danieldegrasse/FlexEval/BOM.xlsx

Sheet: Part Order
Required Qty | Ordered Quantity | Value | Device | Package | Parts | Digikey Part # | Stock (10/16/2022) | Cost Each | Total Cost | Description | A1_MIN | AVAILABILITY | A_MAX | A_MIN | A_NOM | B_MAX | B_MIN | B_NOM | COMMENT | CONFIGURATION_POLE-THROW | CONTACT_CURRENT_RATING | CPU | D1_MAX | D1_MIN | D1_NOM | D2_MAX | DESCRIPTION | DMAX | DMIN | DNOM | D_MAX | D_MIN | D_NOM | E1_MAX | E1_MIN | E1_NOM | E2_MAX | EMAX | EMIN | ENOM | EU_ROHS_COMPLIANCE | E_MAX | E_MIN | E_NOM | FLASHKB | L1_MAX | L1_MIN | L1_NOM | L_MAX | L_MIN | L_NOM | MANUFACTURER | MANUFACTURER_PART_NUMBER | MAXFREQUENCY | MF | MP | MPN | OC_FARNELL | OC_NEWARK
3 | 4 |  | 0603ESDA2-TR2 | 0603ESDA2-TR2 | TVS4, TVS5, TVS6 | 283-4156-1-ND | 95453 | $0.51 | $2.04 | TVS 0603ESDA2-TR2 ESD protection
5 | 5 | 1825910-7 | 1825910-7 | SW_1825910-7 | S1, S2, S3, S4, SW1 | 1825910-7 | 93559 | $0.13 | $0.65 | Switch Tactile OFF (ON) SPST Round Button PC Pins 0.05A 24VDC 100000Cycles 2.55N Thru-Hole Loose Check availability |  | In Stock |  |  |  |  |  |  | 1825910-7 | Single Pole - Single Throw | 50 mA |  |  |  |  |  | Switch Tactile OFF (ON) SPST Round Button PC Pins 0.05A 24VDC 100000Cycle 2.55N Thru-Hole Loose Piece |  |  |  |  |  |  |  |  |  |  |  |  |  | Compliant |  |  |  |  |  |  |  |  |  |  |  |  |  | TE Connectivity | 1825910-7
2 | 3 | 330 | 782853331SMD | 78285333 | L3, L4 | 732-782853331CT-ND | 3995 | $0.25 | $0.75 | 330mOhm Ferrite Bead
1 | 2 | ABM3B-8.000MHZ-B2-T | ABM3B-8.000MHZ-B2-T | OSC_ABM3B-8.000MHZ-B2-T | Y1 | 535-9720-1-ND | 458451 | $0.79 | $1.58 | 8MHz Â±20ppm Crystal 18pF 200 Ohms 4-SMD, No Lead Check availability Check availability Check availability |  | In Stock |  |  |  |  |  |  |  |  |  |  |  |  |  |  | 8 MHz Â±20ppm Crystal 18pF 200 Ohms 4-SMD, No Lead |  |  |  |  |  |  |  |  |  |  |  |  |  |  |  |  |  |  |  |  |  |  |  |  |  |  |  | Abracon | ABM3B-8.000MHZ-B2-T
1 | 2 | ABS07-32.768KHZ-T | ABS07-32.768KHZ-T | XTAL_ABS07-32.768KHZ-T | Y2 | 535-9542-1-ND | 1925810 | $0.73 | $1.46 | ABS07 Series 32.768 kHz Â±20 ppm 12.5 pF -40 to +85 Â°C SMT Low Profile Crystal Check availability |  | In Stock |  |  |  |  |  |  |  |  |  |  |  |  |  |  | 32.768 kHz Â±20ppm Crystal 12.5pF 70 kOhms 2-SMD, No Lead |  |  |  |  |  |  |  |  |  |  |  |  |  |  |  |  |  |  |  |  |  |  |  |  |  |  |  | Abracon | ABS07-32.768KHZ-T
1 | 1 | AP2115M-3.3TRG1 | AP2115M-3.3TRG1 | SOIC127P600X175-8N | U6 | AP2115M-3.3TRG1DICT-ND | 32319 | $0.40 | $0.40 | 3.3V LDO, 1A output max 6V (AP2115M-3.3TRG1)
4 | 6 | BAS16LT3G | BAS16LT3G | SOT95P240X111-3N | D1, D2, D3, D4 | BAS16LT3GOSCT-ND | 21195 | $0.11 | $0.66 | Diode Small Signal Switching 100V 0.2A Automotive 3-Pin SOT-23 T/R Check prices |  | In Stock |  |  |  |  |  |  |  |  |  |  |  |  |  |  | Diode Standard 100V 200mA (DC) Surface Mount SOT-23-3 (TO-236) |  |  |  |  |  |  |  |  |  |  |  |  |  |  |  |  |  |  |  |  |  |  |  |  |  |  |  | ON Semiconductor | BAS16LT3G
7 | 10 | 0.1uF | C-USC0805 | C0805 | C16, C18, C20, C24, C26, C28, C32 | 1276-1180-1-ND | 179561 | $0.10 | $1.00 | CAPACITOR, American symbol (35V rated min)
8 | 12 | 0.47uF | C-USC0805 | C0805 | C17, C19, C21, C22, C25, C27, C29, C30 | 1276-6482-1-ND | 498738 | $0.10 | $1.20 | CAPACITOR, American symbol (35V rated min)
2 | 3 | 12pF | C-USC0805 | C0805 | C33, C34 | 478-1305-1-ND | 57703 | $0.13 | $0.39 | CAPACITOR, American symbol (35V rated min)
1 | 2 | 2.2uF | C-USC0805 | C0805 | C12 | 1276-6702-1-ND | 80757 | $0.22 | $0.44 | CAPACITOR, American symbol (35V rated min)
2 | 3 | 4.7uF | C-USC0805 | C0805 | C13, C14 | 1276-1248-1-ND | 939972 | $0.23 | $0.69 | CAPACITOR, American symbol (35V rated min)
2 | 3 | 1000pF | C-USC1206 | C1206 | C1, C15 | 1276-1050-1-ND | 187675 | $0.11 | $0.33 | CAPACITOR, American symbol (35V rated min)
4 | 6 | 100nF | C-USC1206 | C1206 | C5, C6, C7, C9 | 1276-1017-1-ND | 1373363 | $0.11 | $0.66 | CAPACITOR, American symbol (35V rated min)
4 | 6 | 1uF | C-USC1206 | C1206 | C2, C3, C4, C8 | 1276-1068-1-ND | 910107 | $0.15 | $0.90 | CAPACITOR, American symbol (35V rated min)
2 | 3 | 22pF | C-USC1206 | C1206 | C10, C11 | 1276-1203-1-ND | 186092 | $0.14 | $0.42 | CAPACITOR, American symbol (35V rated min)
2 | 2 | 22uF | 860020672011 | 860020672011 | C23, C31 | 732-8857-1-ND | 23160 | $0.11 | $0.22 | 22uF 50V Electrolytic Capacitor Wurth 860020672011
1 | 2 | GRPB052VWQS-RC | GRPB052VWQS-RC | DEBUG | J2 | S9012E-05-ND | 113007 | $1.05 | $2.10 | CONN HEADER 0.050 | 10PS | DL | SMD | AU" |  | In Stock |  |  |  |  |  |  |  |  |  |  |  |  |  |  | Connector Header Surface Mount 10 position 0.050 (1.27mm) |  |  |  |  |  |  |  |  |  |  |  |  |  |  |  |  |  |  |  |  |  |  |  |  |  |  |  | Sullins Connector
2 | 6 | IS31FL3733B-TQLS4 | IS31FL3733B-TQLS4 | IS31FL3733B-TQLS4 | U3, U4 | 2521-IS31FL3733B-TQLS4-CT-ND | 2189 | $3.23 | $19.38 | IS31FL3733B
96 | 100 |  | LED3MM | LED3MM | LED1, LED2, LED3, LED4, LED5, LED6, LED7, LED8, LED9, LED10, LED11, LED12, LED13, LED14, LED15, LED16, LED17, LED18, LED19, LED20, LED21, LED22, LED23, LED24, LED25, LED26, LED27, LED28, LED29, LED30, LED31, LED32, LED33, LED34, LED35, LED36, LED37, LED38, LED39, LED40, LED41, LED42, LED43, LED44, LED45, LED46, LED47, LED48, LED49, LED50, LED51, LED52, LED53, LED54, LED55, LED56, LED57, LED58, LED59, LED60, LED61, LED62, LED63, LED64, LED65, LED66, LED67, LED68, LED69, LED70, LED71, LED72, LED73, LED74, LED75, LED76, LED77, LED78, LED79, LED80, LED81, LED82, LED83, LED84, LED85, LED86, LED87, LED88, LED89, LED90, LED91, LED92, LED93, LED94, LED95, LED96 | N/A-Order via Amazon (https://www.amazon.com/Transparent-Lighting-Electronics-Components-Emitting/dp/B01BTYHOMC) | ? | $0.07 | $7.00 | 3mm Flangeless LED
1 | 0 |  | MA04-1 | MA04-1 | SV1 | N/A- you have 2.54mm headers | ? | $0.00 | $0.00 | 4 pin 2.54mm pitch header (UART output) |  |  |  |  |  |  |  |  |  |  |  |  |  |  |  |  |  |  |  |  |  |  |  |  |  |  |  |  |  |  |  |  |  |  |  |  |  |  |  |  |  |  |  |  |  |  |  | unknown | unknown
1 | 0 | MK22FX512AVLQ12 | MK22FX512AVLQ12 | LQFP-144_20X20X1.6 | U1 | N/A-you have 5 on hand | 5 | $0.00 | $0.00 | Kinetis MK22FX512AVLQ12 MCU |  |  |  |  |  |  |  |  |  |  |  | ARM Cortex-M4 |  |  |  |  |  |  |  |  |  |  |  |  |  |  |  |  |  |  |  |  |  |  | 512 |  |  |  |  |  |  |  | MK22FX512AVLQ12 | 120
6 | 9 | 100K | R-US_R0805 | R0805 | R6, R7, R8, R14, R15, R16 | RMCF0805FT100KCT-ND | 5202790 | $0.10 | $0.90 | RESISTOR, American symbol
3 | 5 | 200 | R-US_R0805 | R0805 | R2, R3, R9 | RNCP0805FTD200RCT-ND | 147026 | $0.10 | $0.50 | RESISTOR, American symbol
2 | 4 | 33 | R-US_R0805 | R0805 | R10, R19 | A129731CT-ND | 39827 | $0.10 | $0.40 | RESISTOR, American symbol
2 | 4 | 4.7K | R-US_R0805 | R0805 | R4, R5 | 1292-WR08X4701FTLCT-ND | 71676 | $0.10 | $0.40 | RESISTOR, American symbol
2 | 4 | 420K | R-US_R0805 | R0805 | R17, R18 | 311-422KCRCT-ND | 164151 | $0.10 | $0.40 | RESISTOR, American symbol
2 | 4 | 5.1k | R-US_R0805 | R0805 | R20, R21 | A126379CT-ND | 31900 | $0.10 | $0.40 | RESISTOR, American symbol (CC resistors, must be 10% tolerance or better)
2 | 4 | 10k | R-US_R1206 | R1206 | R1, R11 | RNCP1206FTD10K0CT-ND | 270158 | $0.10 | $0.40 | RESISTOR, American symbol
1 | 1 | SOIC127P600X175-8N | TCN75AVOA713 | SOIC127P600X175-8N | U5 | TCN75AVOA713CT-ND | 16252 | $0.89 | $0.89 | TCN75A I2C temperature sensor (SOIC package) | 0.1 |  | 1.75 | 1.75 | 1.75 | 0.51 | 0.31 | 0.41 |  |  |  |  |  |  |  | 0 |  |  |  |  | 4.9 | 4.9 | 4.9 | 3.9 | 3.9 | 3.9 | 0 |  |  | 1.27 |  | 6 | 6 | 6 |  |  |  |  | 1.27 | 0.4 | 0.835 | hotchip
1 | 2 | UPS115UE3/TR7 | UPS115UE3/TR7 | UPS115UE3/TR7 | D5 | 150-UPS115UE3/TR7CT-ND | 1690 | $0.64 | $1.28 | Schottky diode (15V, 220mV@1A)
1 | 2 | USB4105-GF-A | USB4105-GF-A | GCT_USB4105-GF-A | J1 | 2073-USB4105-GF-ACT-ND | 75588 | $0.81 | $1.62 | USB-C (USB TYPE-C) USB 2.0 Receptacle Connector 24 (16+8 Dummy) Position Surface Mount, Right Angle; Through Hole Check availability |  | In Stock |  |  |  |  |  |  |  |  |  |  |  |  |  |  | USB-C (USB TYPE-C) USB 2.0 Receptacle Connector 24 (16+8 Dummy) Position Surface Mount, Right Angle | Through Hole |  |  |  |  |  |  |  |  |  |  |  |  |  |  |  |  |  |  |  |  |  |  |  |  |  |  |  | GCT | USB4105-GF-A
1 | 2 | RED | LEDSML1206 | SML1206 | LED98 | 160-1457-1-ND | 501653 | $0.31 | $0.62 | LED (Red, 1206 package)
1 | 2 | GREEN | LEDSML1206 | SML1206 | LED97 | 160-1456-1-ND | 286482 | $0.31 | $0.62 | LED (Green, 1206 package)
 |  |  |  |  |  |  |  |  | $49.46

Sheet: Parts List
Part | Value | Device | Package | Description | A1_MIN | AVAILABILITY | A_MAX | A_MIN | A_NOM | B_MAX | B_MIN | B_NOM | COMMENT | CONFIGURATION_POLE-THROW | CONTACT_CURRENT_RATING | CPU | D1_MAX | D1_MIN | D1_NOM | D2_MAX | DESCRIPTION | DMAX | DMIN | DNOM | D_MAX | D_MIN | D_NOM | E1_MAX | E1_MIN | E1_NOM | E2_MAX | EMAX | EMIN | ENOM | EU_ROHS_COMPLIANCE | E_MAX | E_MIN | E_NOM | FLASHKB | L1_MAX | L1_MIN | L1_NOM | L_MAX | L_MIN | L_NOM | MANUFACTURER | MANUFACTURER_PART_NUMBER | MAXFREQUENCY | MF | MP | MPN | OC_FARNELL | OC_NEWARK | PACKAGE | PACKAGE_TYPE | PINCOUNT | PINS | PIN_COUNT | POPULARITY
C1 | 1000pF | C-USC1206 | C1206 | CAPACITOR, American symbol
C10 | 22pF | C-USC1206 | C1206 | CAPACITOR, American symbol
C11 | 22pF | C-USC1206 | C1206 | CAPACITOR, American symbol
C12 | 2.2uF | C-USC0805 | C0805 | CAPACITOR, American symbol
C13 | 4.7uF | C-USC0805 | C0805 | CAPACITOR, American symbol
C14 | 4.7uF | C-USC0805 | C0805 | CAPACITOR, American symbol
C15 | 1000pF | C-USC1206 | C1206 | CAPACITOR, American symbol
C16 | 0.1uF | C-USC0805 | C0805 | CAPACITOR, American symbol
C17 | 0.47uF | C-USC0805 | C0805 | CAPACITOR, American symbol
C18 | 0.1uF | C-USC0805 | C0805 | CAPACITOR, American symbol
C19 | 0.47uF | C-USC0805 | C0805 | CAPACITOR, American symbol
C2 | 1uF | C-USC1206 | C1206 | CAPACITOR, American symbol
C20 | 0.1uF | C-USC0805 | C0805 | CAPACITOR, American symbol
C21 | 0.47uF | C-USC0805 | C0805 | CAPACITOR, American symbol
C22 | 0.47uF | C-USC0805 | C0805 | CAPACITOR, American symbol
C23 | 22uF | 860020672011 | 860020672011 | 22uF 50V Electrolytic Capacitor Wurth 860020672011
C24 | 0.1uF | C-USC0805 | C0805 | CAPACITOR, American symbol
C25 | 0.47uF | C-USC0805 | C0805 | CAPACITOR, American symbol
C26 | 0.1uF | C-USC0805 | C0805 | CAPACITOR, American symbol
C27 | 0.47uF | C-USC0805 | C0805 | CAPACITOR, American symbol
C28 | 0.1uF | C-USC0805 | C0805 | CAPACITOR, American symbol
C29 | 0.47uF | C-USC0805 | C0805 | CAPACITOR, American symbol
C3 | 1uF | C-USC1206 | C1206 | CAPACITOR, American symbol
C30 | 0.47uF | C-USC0805 | C0805 | CAPACITOR, American symbol
C31 | 22uF | 860020672011 | 860020672011 | 22uF 50V Electrolytic Capacitor Wurth 860020672011
C32 | 0.1uF | C-USC0805 | C0805 | CAPACITOR, American symbol
C33 | 12pF | C-USC0805 | C0805 | CAPACITOR, American symbol
C34 | 12pF | C-USC0805 | C0805 | CAPACITOR, American symbol
C4 | 1uF | C-USC1206 | C1206 | CAPACITOR, American symbol
C5 | 100nF | C-USC1206 | C1206 | CAPACITOR, American symbol
C6 | 100nF | C-USC1206 | C1206 | CAPACITOR, American symbol
C7 | 100nF | C-USC1206 | C1206 | CAPACITOR, American symbol
C8 | 1uF | C-USC1206 | C1206 | CAPACITOR, American symbol
C9 | 100nF | C-USC1206 | C1206 | CAPACITOR, American symbol
D1 | BAS16LT3G | BAS16LT3G | SOT95P240X111-3N | Diode Small Signal Switching 100V 0.2A Automotive 3-Pin SOT-23 T/R Check prices |  | In Stock |  |  |  |  |  |  |  |  |  |  |  |  |  |  | Diode Standard 100V 200mA (DC) Surface Mount SOT-23-3 (TO-236) |  |  |  |  |  |  |  |  |  |  |  |  |  |  |  |  |  |  |  |  |  |  |  |  |  |  |  | ON Semiconductor | BAS16LT3G |  |  |  | SOT-23-3 ON Semiconductor
D2 | BAS16LT3G | BAS16LT3G | SOT95P240X111-3N | Diode Small Signal Switching 100V 0.2A Automotive 3-Pin SOT-23 T/R Check prices |  | In Stock |  |  |  |  |  |  |  |  |  |  |  |  |  |  | Diode Standard 100V 200mA (DC) Surface Mount SOT-23-3 (TO-236) |  |  |  |  |  |  |  |  |  |  |  |  |  |  |  |  |  |  |  |  |  |  |  |  |  |  |  | ON Semiconductor | BAS16LT3G |  |  |  | SOT-23-3 ON Semiconductor
D3 | BAS16LT3G | BAS16LT3G | SOT95P240X111-3N | Diode Small Signal Switching 100V 0.2A Automotive 3-Pin SOT-23 T/R Check prices |  | In Stock |  |  |  |  |  |  |  |  |  |  |  |  |  |  | Diode Standard 100V 200mA (DC) Surface Mount SOT-23-3 (TO-236) |  |  |  |  |  |  |  |  |  |  |  |  |  |  |  |  |  |  |  |  |  |  |  |  |  |  |  | ON Semiconductor | BAS16LT3G |  |  |  | SOT-23-3 ON Semiconductor
D4 | BAS16LT3G | BAS16LT3G | SOT95P240X111-3N | Diode Small Signal Switching 100V 0.2A Automotive 3-Pin SOT-23 T/R Check prices |  | In Stock |  |  |  |  |  |  |  |  |  |  |  |  |  |  | Diode Standard 100V 200mA (DC) Surface Mount SOT-23-3 (TO-236) |  |  |  |  |  |  |  |  |  |  |  |  |  |  |  |  |  |  |  |  |  |  |  |  |  |  |  | ON Semiconductor | BAS16LT3G |  |  |  | SOT-23-3 ON Semiconductor
D5 | UPS115UE3/TR7 | UPS115UE3/TR7 | UPS115UE3/TR7 | Schottky diode (15V, 220mV@1A)
J1 | USB4105-GF-A | USB4105-GF-A | GCT_USB4105-GF-A | USB-C (USB TYPE-C) USB 2.0 Receptacle Connector 24 (16+8 Dummy) Position Surface Mount, Right Angle; Through Hole Check availability |  | In Stock |  |  |  |  |  |  |  |  |  |  |  |  |  |  | USB-C (USB TYPE-C) USB 2.0 Receptacle Connector 24 (16+8 Dummy) Position Surface Mount, Right Angle | Through Hole |  |  |  |  |  |  |  |  |  |  |  |  |  |  |  |  |  |  |  |  |  |  |  |  |  |  |  | GCT | USB4105-GF-A |  |  |  | None
J2 | GRPB052VWQS-RC | GRPB052VWQS-RC | DEBUG | CONN HEADER SMD 10POS 1.27MM (SWD debug header) | 10PS | DL | SMD | AU" |  | In Stock |  |  |  |  |  |  |  |  |  |  |  |  |  |  | Connector Header Surface Mount 10 position 0.050 (1.27mm) |  |  |  |  |  |  |  |  |  |  |  |  |  |  |  |  |  |  |  |  |  |  |  |  |  |  |  | Sullins Connector | GRPB052VWQS-RC |  |  |  | None
L3 | 330 | 782853331SMD | 78285333 | 330mOhm Ferrite Bead
L4 | 330 | 782853331SMD | 78285333 | 330mOhm Ferrite Bead
LED1 |  | LED3MM | LED3MM | 3mm Flangeless LED |  |  |  |  |  |  |  |  |  |  |  |  |  |  |  |  |  |  |  |  |  |  |  |  |  |  |  |  |  |  |  |  |  |  |  |  |  |  |  |  |  |  |  |  |  |  |  |  |  |  |  |  |  |  | 97
LED10 |  | LED3MM | LED3MM | 3mm Flangeless LED |  |  |  |  |  |  |  |  |  |  |  |  |  |  |  |  |  |  |  |  |  |  |  |  |  |  |  |  |  |  |  |  |  |  |  |  |  |  |  |  |  |  |  |  |  |  |  |  |  |  |  |  |  |  | 97
LED11 |  | LED3MM | LED3MM | 3mm Flangeless LED |  |  |  |  |  |  |  |  |  |  |  |  |  |  |  |  |  |  |  |  |  |  |  |  |  |  |  |  |  |  |  |  |  |  |  |  |  |  |  |  |  |  |  |  |  |  |  |  |  |  |  |  |  |  | 97
LED12 |  | LED3MM | LED3MM | 3mm Flangeless LED |  |  |  |  |  |  |  |  |  |  |  |  |  |  |  |  |  |  |  |  |  |  |  |  |  |  |  |  |  |  |  |  |  |  |  |  |  |  |  |  |  |  |  |  |  |  |  |  |  |  |  |  |  |  | 97
LED13 |  | LED3MM | LED3MM | 3mm Flangeless LED |  |  |  |  |  |  |  |  |  |  |  |  |  |  |  |  |  |  |  |  |  |  |  |  |  |  |  |  |  |  |  |  |  |  |  |  |  |  |  |  |  |  |  |  |  |  |  |  |  |  |  |  |  |  | 97
LED14 |  | LED3MM | LED3MM | 3mm Flangeless LED |  |  |  |  |  |  |  |  |  |  |  |  |  |  |  |  |  |  |  |  |  |  |  |  |  |  |  |  |  |  |  |  |  |  |  |  |  |  |  |  |  |  |  |  |  |  |  |  |  |  |  |  |  |  | 97
LED15 |  | LED3MM | LED3MM | 3mm Flangeless LED |  |  |  |  |  |  |  |  |  |  |  |  |  |  |  |  |  |  |  |  |  |  |  |  |  |  |  |  |  |  |  |  |  |  |  |  |  |  |  |  |  |  |  |  |  |  |  |  |  |  |  |  |  |  | 97
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
LED92 |  | LED3MM | LED3MM | 3mm Flangeless LED |  |  |  |  |  |  |  |  |  |  |  |  |  |  |  |  |  |  |  |  |  |  |  |  |  |  |  |  |  |  |  |  |  |  |  |  |  |  |  |  |  |  |  |  |  |  |  |  |  |  |  |  |  |  | 97
LED93 |  | LED3MM | LED3MM | 3mm Flangeless LED |  |  |  |  |  |  |  |  |  |  |  |  |  |  |  |  |  |  |  |  |  |  |  |  |  |  |  |  |  |  |  |  |  |  |  |  |  |  |  |  |  |  |  |  |  |  |  |  |  |  |  |  |  |  | 97
LED94 |  | LED3MM | LED3MM | 3mm Flangeless LED |  |  |  |  |  |  |  |  |  |  |  |  |  |  |  |  |  |  |  |  |  |  |  |  |  |  |  |  |  |  |  |  |  |  |  |  |  |  |  |  |  |  |  |  |  |  |  |  |  |  |  |  |  |  | 97
LED95 |  | LED3MM | LED3MM | 3mm Flangeless LED |  |  |  |  |  |  |  |  |  |  |  |  |  |  |  |  |  |  |  |  |  |  |  |  |  |  |  |  |  |  |  |  |  |  |  |  |  |  |  |  |  |  |  |  |  |  |  |  |  |  |  |  |  |  | 97
LED96 |  | LED3MM | LED3MM | 3mm Flangeless LED |  |  |  |  |  |  |  |  |  |  |  |  |  |  |  |  |  |  |  |  |  |  |  |  |  |  |  |  |  |  |  |  |  |  |  |  |  |  |  |  |  |  |  |  |  |  |  |  |  |  |  |  |  |  | 97
LED97 | GREEN | LEDSML1206 | SML1206 | LED |  |  |  |  |  |  |  |  |  |  |  |  |  |  |  |  |  |  |  |  |  |  |  |  |  |  |  |  |  |  |  |  |  |  |  |  |  |  |  |  |  |  |  |  |  |  |  |  |  |  |  |  |  |  | 6
LED98 | RED | LEDSML1206 | SML1206 | LED |  |  |  |  |  |  |  |  |  |  |  |  |  |  |  |  |  |  |  |  |  |  |  |  |  |  |  |  |  |  |  |  |  |  |  |  |  |  |  |  |  |  |  |  |  |  |  |  |  |  |  |  |  |  | 6
R1 | 10k | R-US_R1206 | R1206 | RESISTOR, American symbol
R10 | 33 | R-US_R0805 | R0805 | RESISTOR, American symbol
R11 | 10k | R-US_R1206 | R1206 | RESISTOR, American symbol
R14 | 100K | R-US_R0805 | R0805 | RESISTOR, American symbol
R15 | 100K | R-US_R0805 | R0805 | RESISTOR, American symbol
R16 | 100K | R-US_R0805 | R0805 | RESISTOR, American symbol
R17 | 420K | R-US_R0805 | R0805 | RESISTOR, American symbol
R18 | 420K | R-US_R0805 | R0805 | RESISTOR, American symbol
R19 | 33 | R-US_R0805 | R0805 | RESISTOR, American symbol
R2 | 200 | R-US_R0805 | R0805 | RESISTOR, American symbol
R20 | 5.1k | R-US_R0805 | R0805 | RESISTOR, American symbol
R21 | 5.1k | R-US_R0805 | R0805 | RESISTOR, American symbol
R3 | 200 | R-US_R0805 | R0805 | RESISTOR, American symbol
R4 | 4.7K | R-US_R0805 | R0805 | RESISTOR, American symbol
R5 | 4.7K | R-US_R0805 | R0805 | RESISTOR, American symbol
R6 | 100K | R-US_R0805 | R0805 | RESISTOR, American symbol
R7 | 100K | R-US_R0805 | R0805 | RESISTOR, American symbol
R8 | 100K | R-US_R0805 | R0805 | RESISTOR, American symbol
R9 | 200 | R-US_R0805 | R0805 | RESISTOR, American symbol
S1 | 1825910-7 | 1825910-7 | SW_1825910-7 | Switch Tactile OFF (ON) SPST Round Button PC Pins 0.05A 24VDC 100000Cycles 2.55N Thru-Hole Loose Check availability |  | In Stock |  |  |  |  |  |  | 1825910-7 | Single Pole - Single Throw | 50 mA |  |  |  |  |  | Switch Tactile OFF (ON) SPST Round Button PC Pins 0.05A 24VDC 100000Cycle 2.55N Thru-Hole Loose Piece |  |  |  |  |  |  |  |  |  |  |  |  |  | Compliant |  |  |  |  |  |  |  |  |  |  |  |  |  | TE Connectivity | 1825910-7 |  |  |  | None
S2 | 1825910-7 | 1825910-7 | SW_1825910-7 | Switch Tactile OFF (ON) SPST Round Button PC Pins 0.05A 24VDC 100000Cycles 2.55N Thru-Hole Loose Check availability |  | In Stock |  |  |  |  |  |  | 1825910-7 | Single Pole - Single Throw | 50 mA |  |  |  |  |  | Switch Tactile OFF (ON) SPST Round Button PC Pins 0.05A 24VDC 100000Cycle 2.55N Thru-Hole Loose Piece |  |  |  |  |  |  |  |  |  |  |  |  |  | Compliant |  |  |  |  |  |  |  |  |  |  |  |  |  | TE Connectivity | 1825910-7 |  |  |  | None
S3 | 1825910-7 | 1825910-7 | SW_1825910-7 | Switch Tactile OFF (ON) SPST Round Button PC Pins 0.05A 24VDC 100000Cycles 2.55N Thru-Hole Loose Check availability |  | In Stock |  |  |  |  |  |  | 1825910-7 | Single Pole - Single Throw | 50 mA |  |  |  |  |  | Switch Tactile OFF (ON) SPST Round Button PC Pins 0.05A 24VDC 100000Cycle 2.55N Thru-Hole Loose Piece |  |  |  |  |  |  |  |  |  |  |  |  |  | Compliant |  |  |  |  |  |  |  |  |  |  |  |  |  | TE Connectivity | 1825910-7 |  |  |  | None
S4 | 1825910-7 | 1825910-7 | SW_1825910-7 | Switch Tactile OFF (ON) SPST Round Button PC Pins 0.05A 24VDC 100000Cycles 2.55N Thru-Hole Loose Check availability |  | In Stock |  |  |  |  |  |  | 1825910-7 | Single Pole - Single Throw | 50 mA |  |  |  |  |  | Switch Tactile OFF (ON) SPST Round Button PC Pins 0.05A 24VDC 100000Cycle 2.55N Thru-Hole Loose Piece |  |  |  |  |  |  |  |  |  |  |  |  |  | Compliant |  |  |  |  |  |  |  |  |  |  |  |  |  | TE Connectivity | 1825910-7 |  |  |  | None
SJ1 |  | SJ2W | SJ_2 | SMD solder JUMPER |  |  |  |  |  |  |  |  |  |  |  |  |  |  |  |  |  |  |  |  |  |  |  |  |  |  |  |  |  |  |  |  |  |  |  |  |  |  |  |  |  |  |  |  |  |  |  |  |  |  |  |  |  |  | 7
SV1 |  | MA04-1 | MA04-1 | 4 pin 2.54mm pitch header (UART output) |  |  |  |  |  |  |  |  |  |  |  |  |  |  |  |  |  |  |  |  |  |  |  |  |  |  |  |  |  |  |  |  |  |  |  |  |  |  |  |  |  |  |  |  |  |  |  | unknown | unknown |  |  |  |  |  | 41
SW1 | 1825910-7 | 1825910-7 | SW_1825910-7 | Switch Tactile OFF (ON) SPST Round Button PC Pins 0.05A 24VDC 100000Cycles 2.55N Thru-Hole Loose Check availability |  | In Stock |  |  |  |  |  |  | 1825910-7 | Single Pole - Single Throw | 50 mA |  |  |  |  |  | Switch Tactile OFF (ON) SPST Round Button PC Pins 0.05A 24VDC 100000Cycle 2.55N Thru-Hole Loose Piece |  |  |  |  |  |  |  |  |  |  |  |  |  | Compliant |  |  |  |  |  |  |  |  |  |  |  |  |  | TE Connectivity | 1825910-7 |  |  |  | None
TP1 | TPSQTP20R | TPSQTP20R | TP20R | Test pad |  |  |  |  |  |  |  |  |  |  |  |  |  |  |  |  |  |  |  |  |  |  |  |  |  |  |  |  |  |  |  |  |  |  |  |  |  |  |  |  |  |  |  |  |  |  |  |  |  |  |  |  |  |  | 2
TP2 | TPSQTP20R | TPSQTP20R | TP20R | Test pad |  |  |  |  |  |  |  |  |  |  |  |  |  |  |  |  |  |  |  |  |  |  |  |  |  |  |  |  |  |  |  |  |  |  |  |  |  |  |  |  |  |  |  |  |  |  |  |  |  |  |  |  |  |  | 2
TP3 | TPSQTP20R | TPSQTP20R | TP20R | Test pad |  |  |  |  |  |  |  |  |  |  |  |  |  |  |  |  |  |  |  |  |  |  |  |  |  |  |  |  |  |  |  |  |  |  |  |  |  |  |  |  |  |  |  |  |  |  |  |  |  |  |  |  |  |  | 2
TP4 | TPSQTP20R | TPSQTP20R | TP20R | Test pad |  |  |  |  |  |  |  |  |  |  |  |  |  |  |  |  |  |  |  |  |  |  |  |  |  |  |  |  |  |  |  |  |  |  |  |  |  |  |  |  |  |  |  |  |  |  |  |  |  |  |  |  |  |  | 2
TP5 | TPSQTP20R | TPSQTP20R | TP20R | Test pad |  |  |  |  |  |  |  |  |  |  |  |  |  |  |  |  |  |  |  |  |  |  |  |  |  |  |  |  |  |  |  |  |  |  |  |  |  |  |  |  |  |  |  |  |  |  |  |  |  |  |  |  |  |  | 2
TVS4 |  | 0603ESDA2-TR2 | 0603ESDA2-TR2 | TVS 0603ESDA2-TR2 ESD protection
TVS5 |  | 0603ESDA2-TR2 | 0603ESDA2-TR2 | TVS 0603ESDA2-TR2 ESD protection
TVS6 |  | 0603ESDA2-TR2 | 0603ESDA2-TR2 | TVS 0603ESDA2-TR2 ESD protection
U1 | MK22FX512AVLQ12 | MK22FX512AVLQ12 | LQFP-144_20X20X1.6 | Kinetis MK22FX512AVLQ12 MCU |  |  |  |  |  |  |  |  |  |  |  | ARM Cortex-M4 |  |  |  |  |  |  |  |  |  |  |  |  |  |  |  |  |  |  |  |  |  |  | 512 |  |  |  |  |  |  |  | MK22FX512AVLQ12 | 120 |  |  |  |  |  |  |  | 144
U3 | IS31FL3733B-TQLS4 | IS31FL3733B-TQLS4 | IS31FL3733B-TQLS4 | IS31FL3733B LED Driver
U4 | IS31FL3733B-TQLS4 | IS31FL3733B-TQLS4 | IS31FL3733B-TQLS4 | IS31FL3733B LED Driver
U5 | SOIC127P600X175-8N | TCN75AVOA713 | SOIC127P600X175-8N | TCN75A I2C temperature sensor (SOIC package) | 0.1 |  | 1.75 | 1.75 | 1.75 | 0.51 | 0.31 | 0.41 |  |  |  |  |  |  |  | 0 |  |  |  |  | 4.9 | 4.9 | 4.9 | 3.9 | 3.9 | 3.9 | 0 |  |  | 1.27 |  | 6 | 6 | 6 |  |  |  |  | 1.27 | 0.4 | 0.835 | hotchip |  |  |  |  |  |  |  |  |  |  |  | 8
U6 | AP2115M-3.3TRG1 | AP2115M-3.3TRG1 | SOIC127P600X175-8N | 3.3V LDO, 1A output max 6V (AP2115M-3.3TRG1)
Y1 | ABM3B-8.000MHZ-B2-T | ABM3B-8.000MHZ-B2-T | OSC_ABM3B-8.000MHZ-B2-T | 8MHz Â±20ppm Crystal 18pF 200 Ohms 4-SMD, No Lead Check availability Check availability Check availability |  | In Stock |  |  |  |  |  |  |  |  |  |  |  |  |  |  | 8 MHz Â±20ppm Crystal 18pF 200 Ohms 4-SMD, No Lead |  |  |  |  |  |  |  |  |  |  |  |  |  |  |  |  |  |  |  |  |  |  |  |  |  |  |  | Abracon | ABM3B-8.000MHZ-B2-T |  |  |  | SMD-4 Abracon LLC
Y2 | ABS07-32.768KHZ-T | ABS07-32.768KHZ-T | XTAL_ABS07-32.768KHZ-T | ABS07 Series 32.768 kHz Â±20 ppm 12.5 pF -40 to +85 Â°C SMT Low Profile Crystal Check availability |  | In Stock |  |  |  |  |  |  |  |  |  |  |  |  |  |  | 32.768 kHz Â±20ppm Crystal 12.5pF 70 kOhms 2-SMD, No Lead |  |  |  |  |  |  |  |  |  |  |  |  |  |  |  |  |  |  |  |  |  |  |  |  |  |  |  | Abracon | ABS07-32.768KHZ-T |  |  |  | SMD-2 Abracon LLC
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
