danieldegrasse/FlexEval/SCHEMATIC.pdf

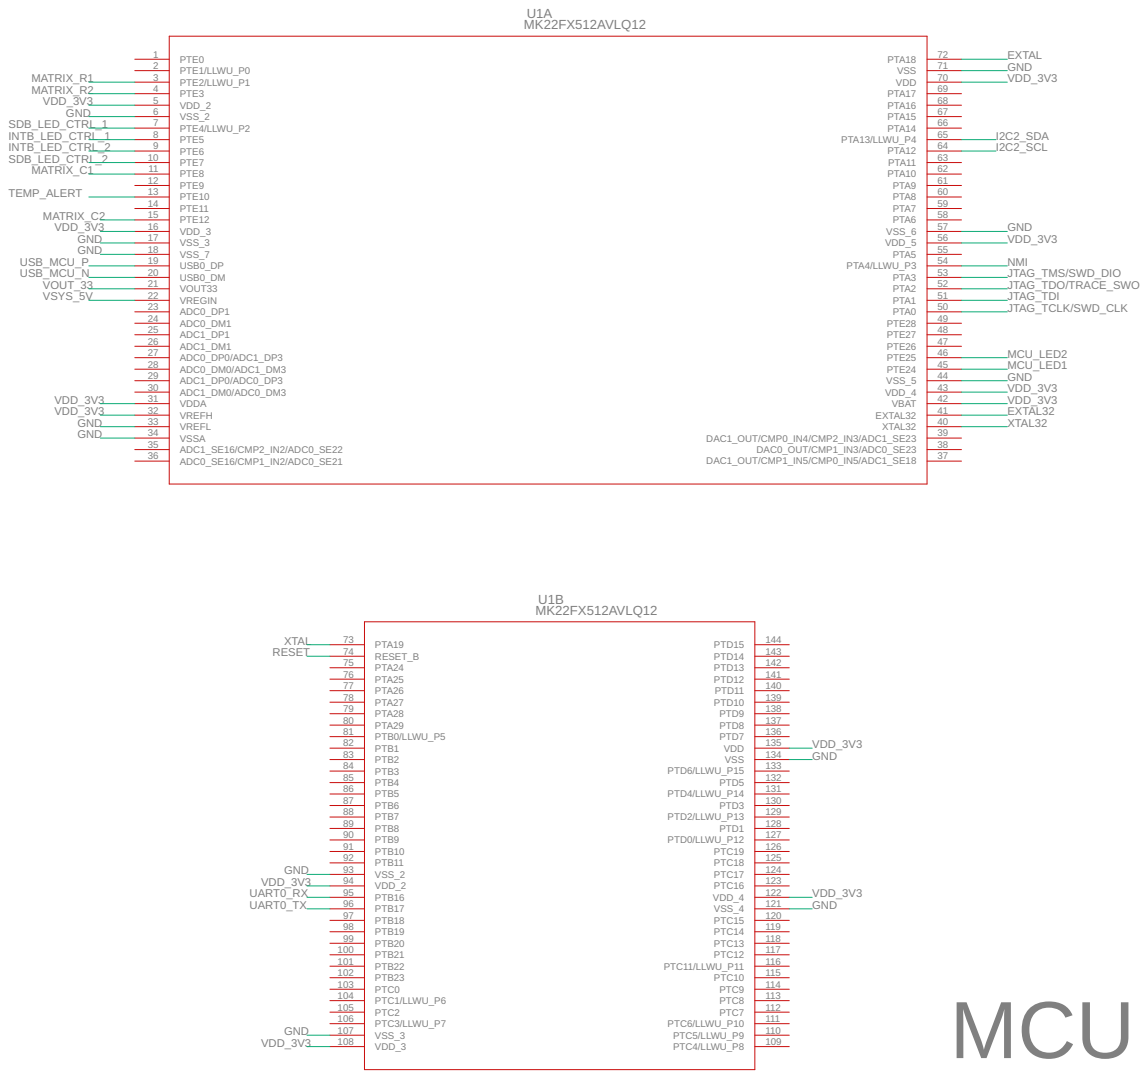
[picture p1: page 1]

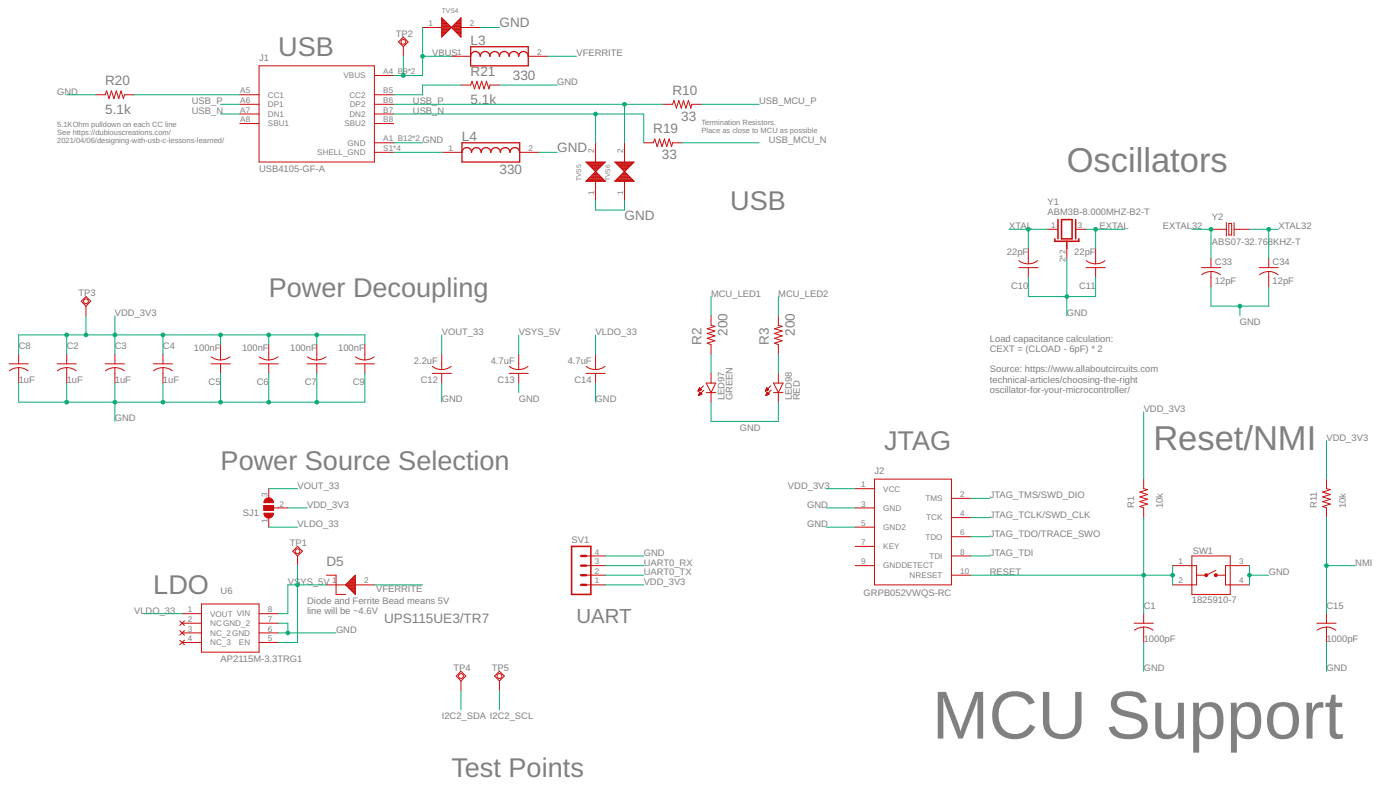
[picture p2: page 2]

Load capacitance calculation: CEXT = (CLOAD - 6pF) * 2 Source: https://www.allaboutcircuits.com

technical-articles/choosing-the-right oscillator-for-your-microcontroller/

VSYS_5V
Diode and Ferrite Bead means 5V
line will be ~4.6V
GND

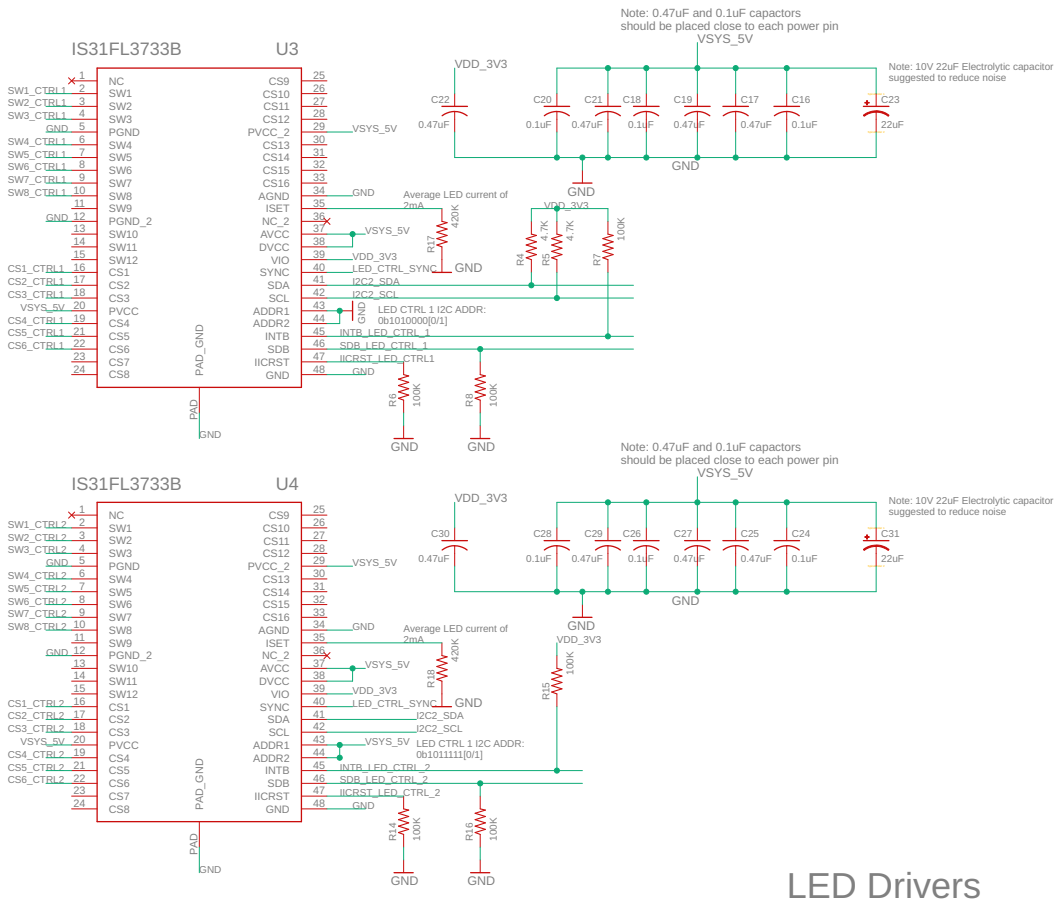
[picture p3: page 3]

Note: 0.47uF and 0.1uF capactors
should be placed close to each power pin

Note: 10V 22uF Electrolytic capacitor suggested to reduce noise

Average LED current of 2mA

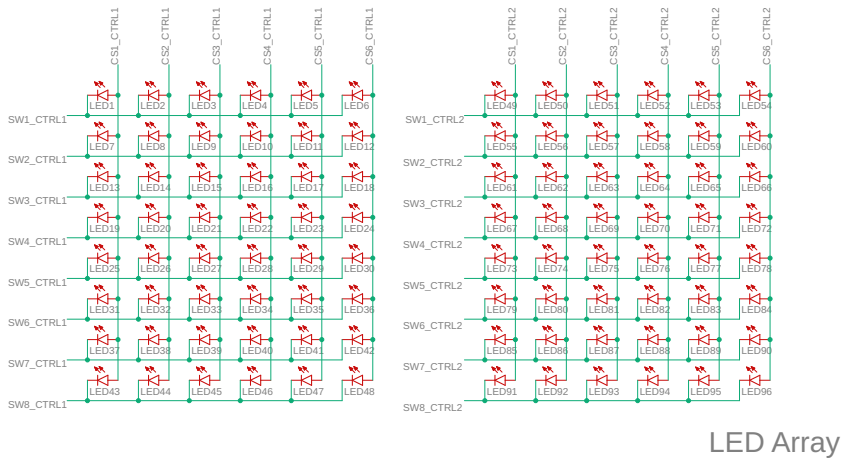
[picture p4: page 4]

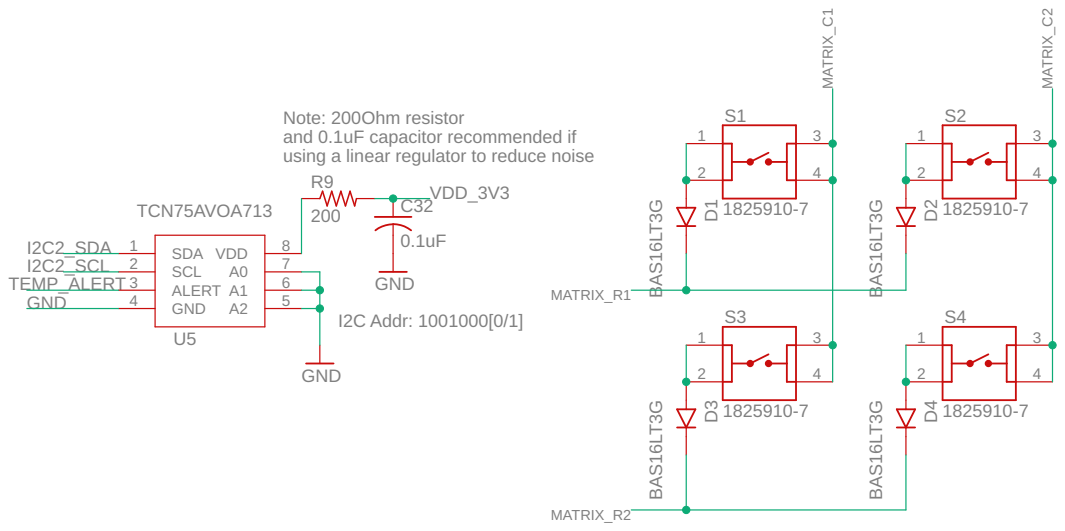
[picture p5: page 5]

Note: 200Ohm resistor and 0.1uF capacitor recommended if using a linear regulator to reduce noise TCN75AVOA713
