danieldegrasse/FlexEval/LAYOUT.pdf

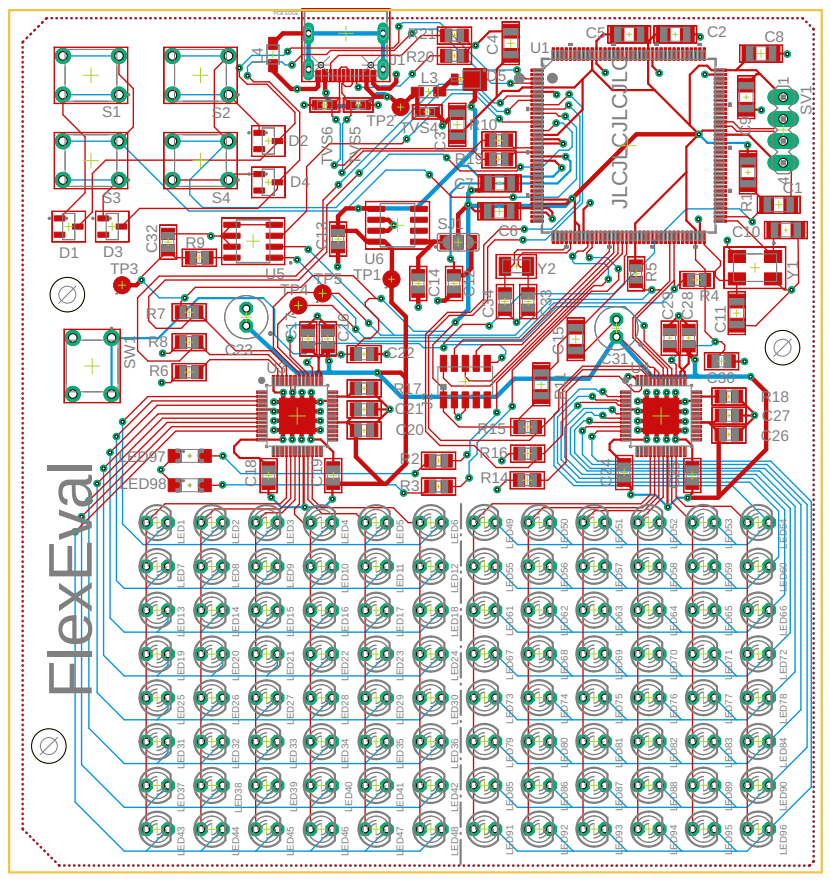
[picture p6: page 1]
