danieldegrasse/FlexEval/FlexEval.brd

## EAGLE design FlexEval.brd (2022-10-16)

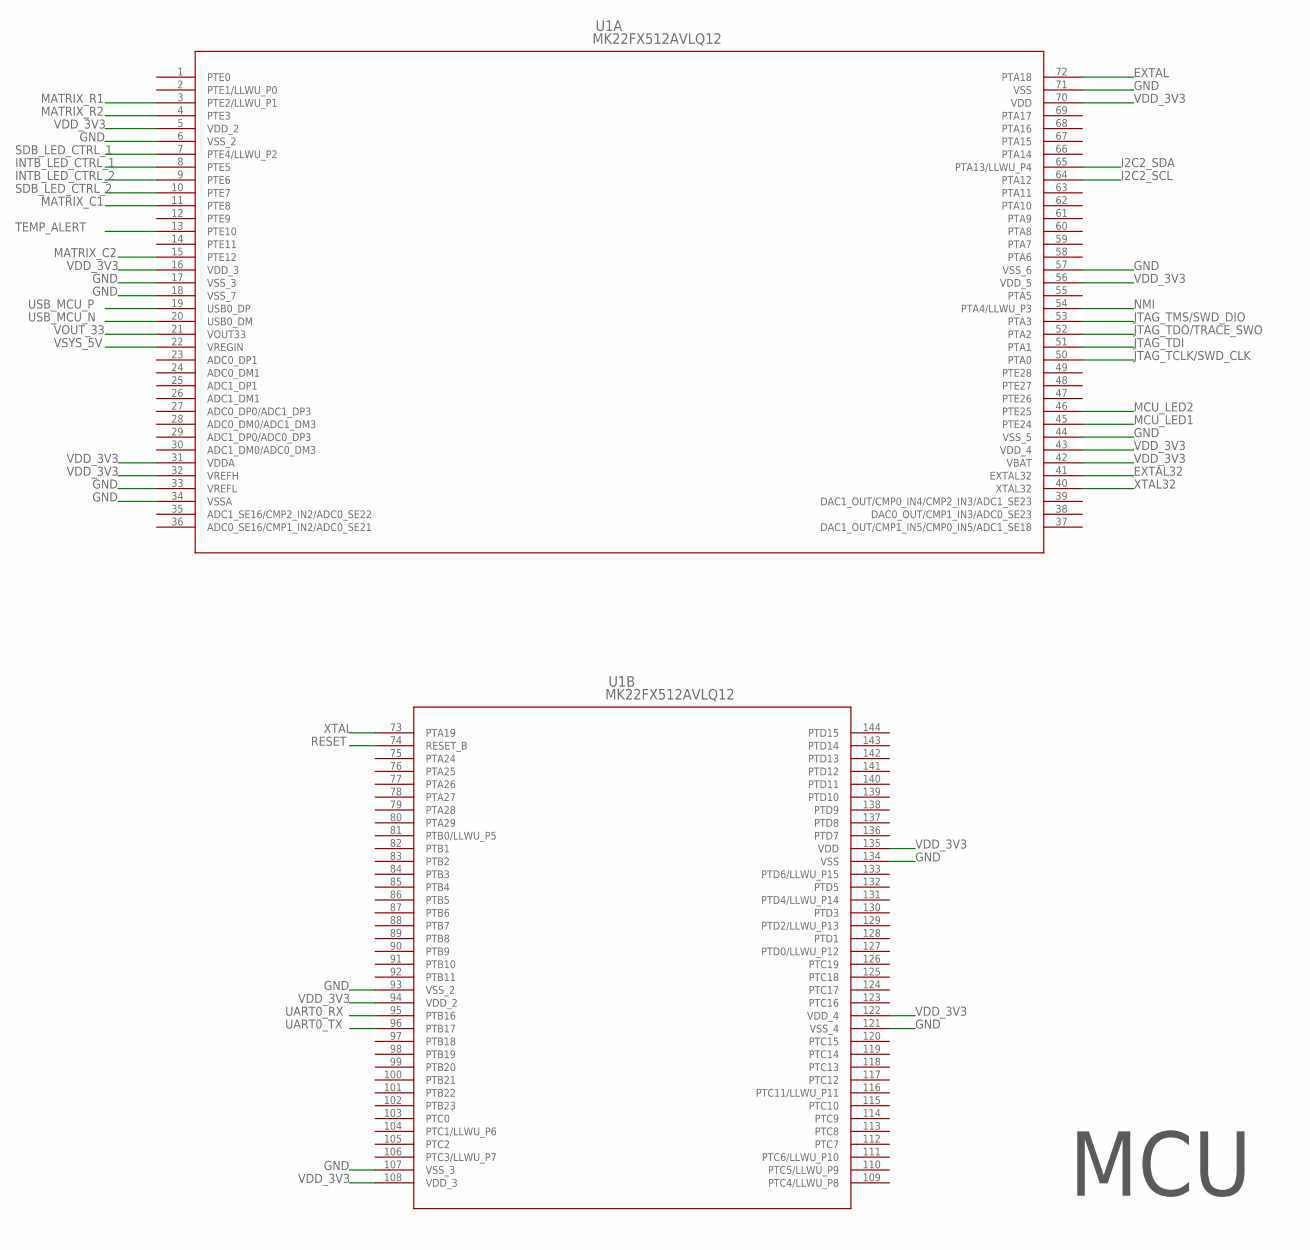
[picture p7: schematic FlexEval.sch, sheet 1]

Parts:
U1: MK22FX512AVLQ12; LQFP-144_20X20X1.6

Connections:
EXTAL: U1.72 (PTA18); also elsewhere on the board
EXTAL32: U1.41 (EXTAL32); also elsewhere on the board
GND: U1.6 (VSS_2), U1.17 (VSS_3), U1.18 (VSS_7), U1.33 (VREFL), U1.34 (VSSA), U1.44 (VSS_5), U1.57 (VSS_6), U1.71 (VSS), U1.93 (VSS_2), U1.107 (VSS_3), U1.121 (VSS_4), U1.134 (VSS); also elsewhere on the board
I2C2_SCL: U1.64 (PTA12); also elsewhere on the board
I2C2_SDA: U1.65 (PTA13/LLWU_P4); also elsewhere on the board
INTB_LED_CTRL_1: U1.8 (PTE5); also elsewhere on the board
INTB_LED_CTRL_2: U1.9 (PTE6); also elsewhere on the board
JTAG_TCLK/SWD_CLK: U1.50 (PTA0); also elsewhere on the board
JTAG_TDI: U1.51 (PTA1); also elsewhere on the board
JTAG_TDO/TRACE_SWO: U1.52 (PTA2); also elsewhere on the board
JTAG_TMS/SWD_DIO: U1.53 (PTA3); also elsewhere on the board
MATRIX_C1: U1.11 (PTE8); also elsewhere on the board
MATRIX_C2: U1.15 (PTE12); also elsewhere on the board
MATRIX_R1: U1.3 (PTE2/LLWU_P1); also elsewhere on the board
MATRIX_R2: U1.4 (PTE3); also elsewhere on the board
MCU_LED1: U1.45 (PTE24); also elsewhere on the board
MCU_LED2: U1.46 (PTE25); also elsewhere on the board
NMI: U1.54 (PTA4/LLWU_P3); also elsewhere on the board
RESET: U1.74 (RESET_B); also elsewhere on the board
SDB_LED_CTRL_1: U1.7 (PTE4/LLWU_P2); also elsewhere on the board
SDB_LED_CTRL_2: U1.10 (PTE7); also elsewhere on the board
TEMP_ALERT: U1.13 (PTE10); also elsewhere on the board
UART0_RX: U1.95 (PTB16); also elsewhere on the board
UART0_TX: U1.96 (PTB17); also elsewhere on the board
USB_MCU_N: U1.20 (USB0_DM); also elsewhere on the board
USB_MCU_P: U1.19 (USB0_DP); also elsewhere on the board
VDD_3V3: U1.5 (VDD_2), U1.16 (VDD_3), U1.31 (VDDA), U1.32 (VREFH), U1.42 (VBAT), U1.43 (VDD_4), U1.56 (VDD_5), U1.70 (VDD), U1.94 (VDD_2), U1.108 (VDD_3), U1.122 (VDD_4), U1.135 (VDD); also elsewhere on the board
VOUT_33: U1.21 (VOUT33); also elsewhere on the board
VSYS_5V: U1.22 (VREGIN); also elsewhere on the board
XTAL: U1.73 (PTA19); also elsewhere on the board
XTAL32: U1.40 (XTAL32); also elsewhere on the board

Notes on the sheet:
MCU

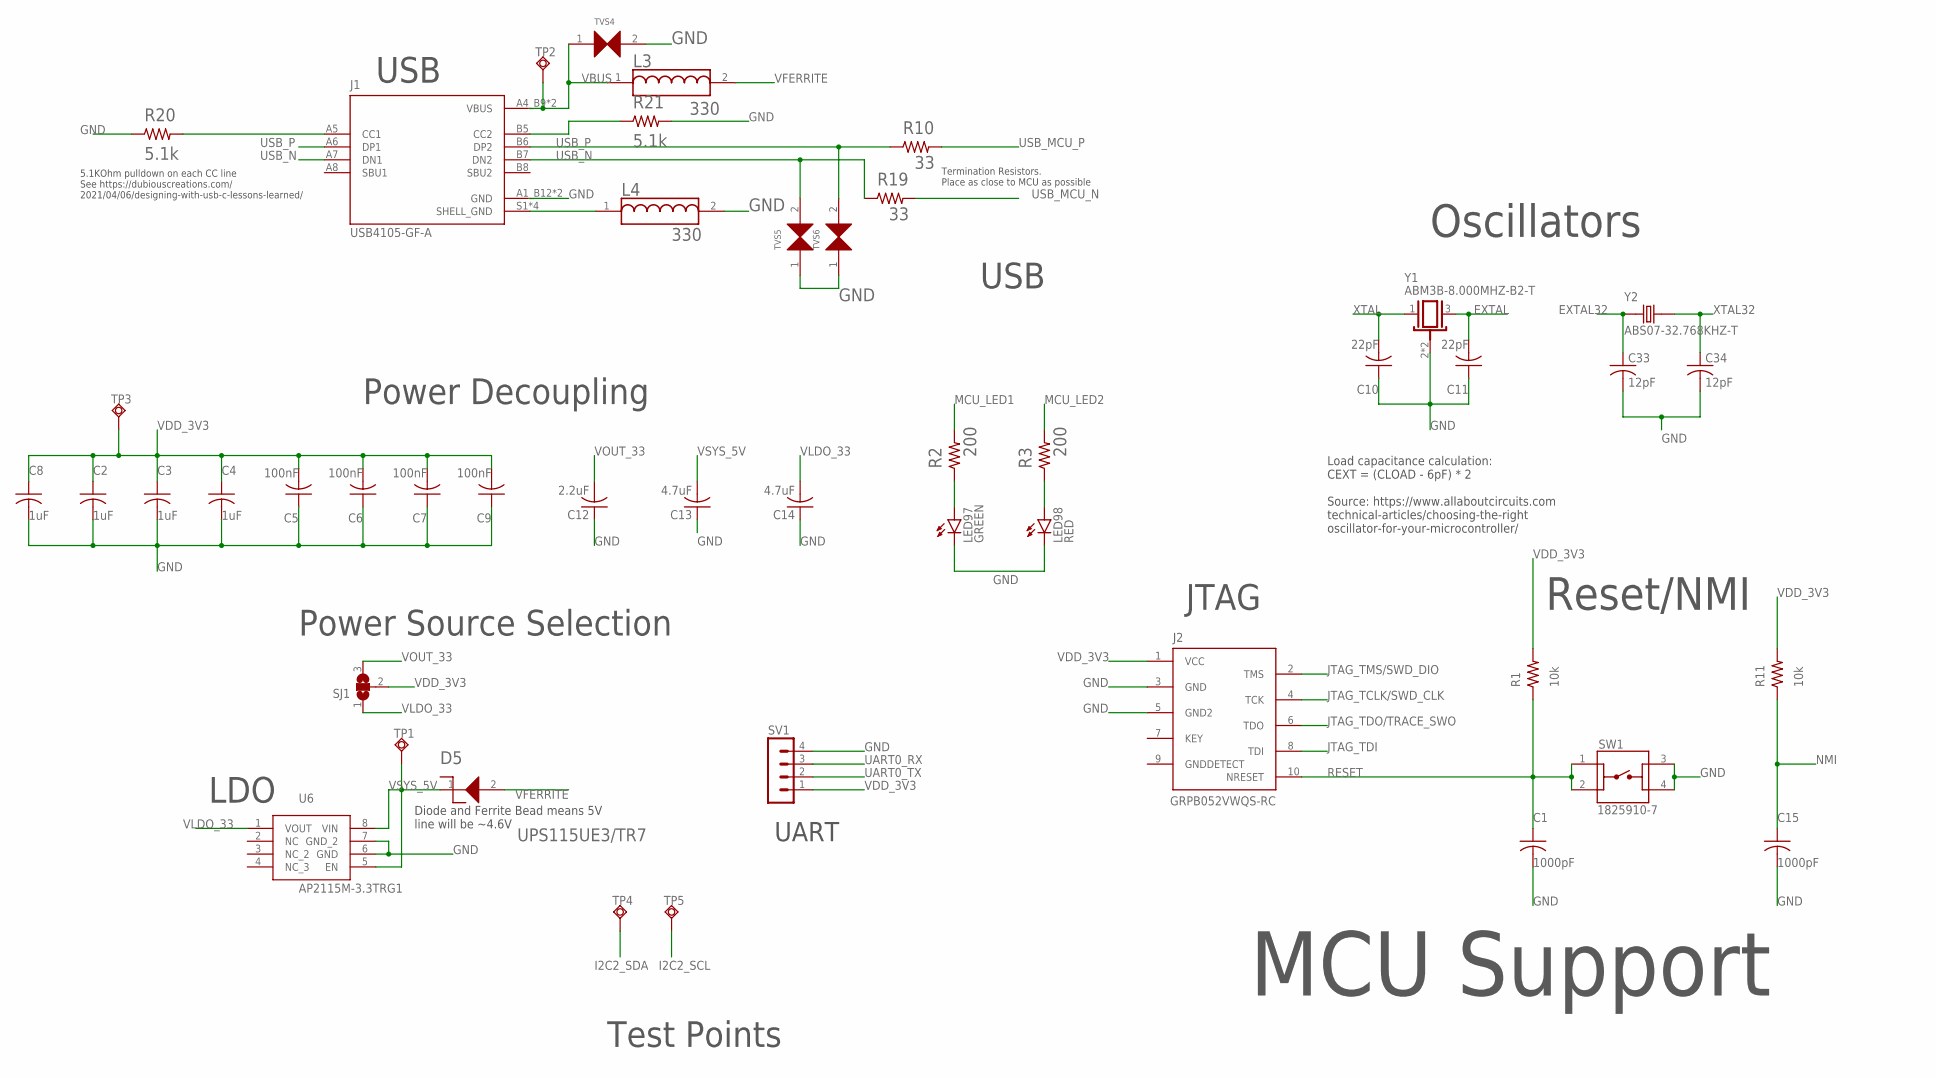
[picture p8: schematic FlexEval.sch, sheet 2]

Parts:
C1, C15: 1000pF; C1206
C2, C3, C4, C8: 1uF; C1206
C5, C6, C7, C9: 100nF; C1206
C10, C11: 22pF; C1206
C12: 2.2uF; C0805
C13, C14: 4.7uF; C0805
C33, C34: 12pF; C0805
D5: UPS115UE3/TR7
J1: USB4105-GF-A; GCT_USB4105-GF-A
J2: GRPB052VWQS-RC; DEBUG
L3, L4: 330; 78285333
LED97: GREEN; SML1206
LED98: RED; SML1206
R1, R11: 10k; R1206
R2, R3: 200; R0805
R10, R19: 33; R0805
R20, R21: 5.1k; R0805
SJ1: SJ2W; SJ_2
SV1: MA04-1
SW1: 1825910-7; SW_1825910-7
TP1, TP2, TP3, TP4, TP5: TPSQTP20R; TP20R
TVS4, TVS5, TVS6: 0603ESDA2-TR2
U6: AP2115M-3.3TRG1; SOIC127P600X175-8N
Y1: ABM3B-8.000MHZ-B2-T; OSC_ABM3B-8.000MHZ-B2-T
Y2: ABS07-32.768KHZ-T; XTAL_ABS07-32.768KHZ-T

Connections:
EXTAL: C11.2, Y1.3; also elsewhere on the board
EXTAL32: C33.1, Y2.1; also elsewhere on the board
GND: C1.2, C2.2, C3.2, C4.2, C5.1, C6.1, C7.1, C8.2, C9.1, C10.1, C11.1, C12.1, C13.1, C14.1, C15.2, C33.2, C34.2, J1.A1_B12 (GND), J1.B1_A12 (GND), J2.3 (GND), J2.5 (GND2), L4.2, LED97.C, LED98.C, R20.1, R21.2, SV1.4, SW1.3, SW1.4, TVS4.2, TVS5.1, TVS6.1, U6.6 (GND), U6.7 (GND_2), Y1.2 (GND), Y1.4 (GND); also elsewhere on the board
I2C2_SCL: TP5.TP; also elsewhere on the board
I2C2_SDA: TP4.TP; also elsewhere on the board
JTAG_TCLK/SWD_CLK: J2.4 (TCK); also elsewhere on the board
JTAG_TDI: J2.8 (TDI); also elsewhere on the board
JTAG_TDO/TRACE_SWO: J2.6 (TDO); also elsewhere on the board
JTAG_TMS/SWD_DIO: J2.2 (TMS); also elsewhere on the board
MCU_LED1: R2.2; also elsewhere on the board
MCU_LED2: R3.2; also elsewhere on the board
unnamed: LED97.A, R2.1
unnamed: LED98.A, R3.1
unnamed: J1.S1 (SHELL_GND), J1.S2 (SHELL_GND), J1.S3 (SHELL_GND), J1.S4 (SHELL_GND), L4.1
unnamed: J1.B5 (CC2), R21.1
unnamed: J1.A5 (CC1), R20.2
NMI: C15.1, R11.1; also elsewhere on the board
RESET: C1.1, J2.10 (NRESET), R1.1, SW1.1, SW1.2; also elsewhere on the board
UART0_RX: SV1.3; also elsewhere on the board
UART0_TX: SV1.2; also elsewhere on the board
USB_MCU_N: R19.2; also elsewhere on the board
USB_MCU_P: R10.2; also elsewhere on the board
USB_N: J1.A7 (DN1), J1.B7 (DN2), R19.1, TVS5.2
USB_P: J1.A6 (DP1), J1.B6 (DP2), R10.1, TVS6.2
VBUS: J1.A4_B9 (VBUS), J1.B4_A9 (VBUS), L3.1, TP2.TP, TVS4.1
VDD_3V3: C2.1, C3.1, C4.1, C5.2, C6.2, C7.2, C8.1, C9.2, J2.1 (VCC), R1.2, R11.2, SJ1.2, SV1.1, TP3.TP; also elsewhere on the board
VFERRITE: D5.2, L3.2
VLDO_33: C14.2, SJ1.1, U6.1 (VOUT)
VOUT_33: C12.2, SJ1.3; also elsewhere on the board
VSYS_5V: C13.2, D5.1, TP1.TP, U6.5 (EN), U6.8 (VIN); also elsewhere on the board
XTAL: C10.2, Y1.1; also elsewhere on the board
XTAL32: C34.1, Y2.2; also elsewhere on the board

Notes on the sheet:
USB
JTAG
UART
Power Source Selection
Power Decoupling
LDO
Reset/NMI
Oscillators
MCU Support
Diode and Ferrite Bead means 5V line will be ~4.6V
Load capacitance calculation: CEXT = (CLOAD - 6pF) * 2 Source: https://www.allaboutcircuits.com technical-articles/choosing-the-right oscillator-for-your-microcontroller/
5.1KOhm pulldown on each CC line See https://dubiouscreations.com/ 2021/04/06/designing-with-usb-c-lessons-learned/
Termination Resistors. Place as close to MCU as possible
Test Points

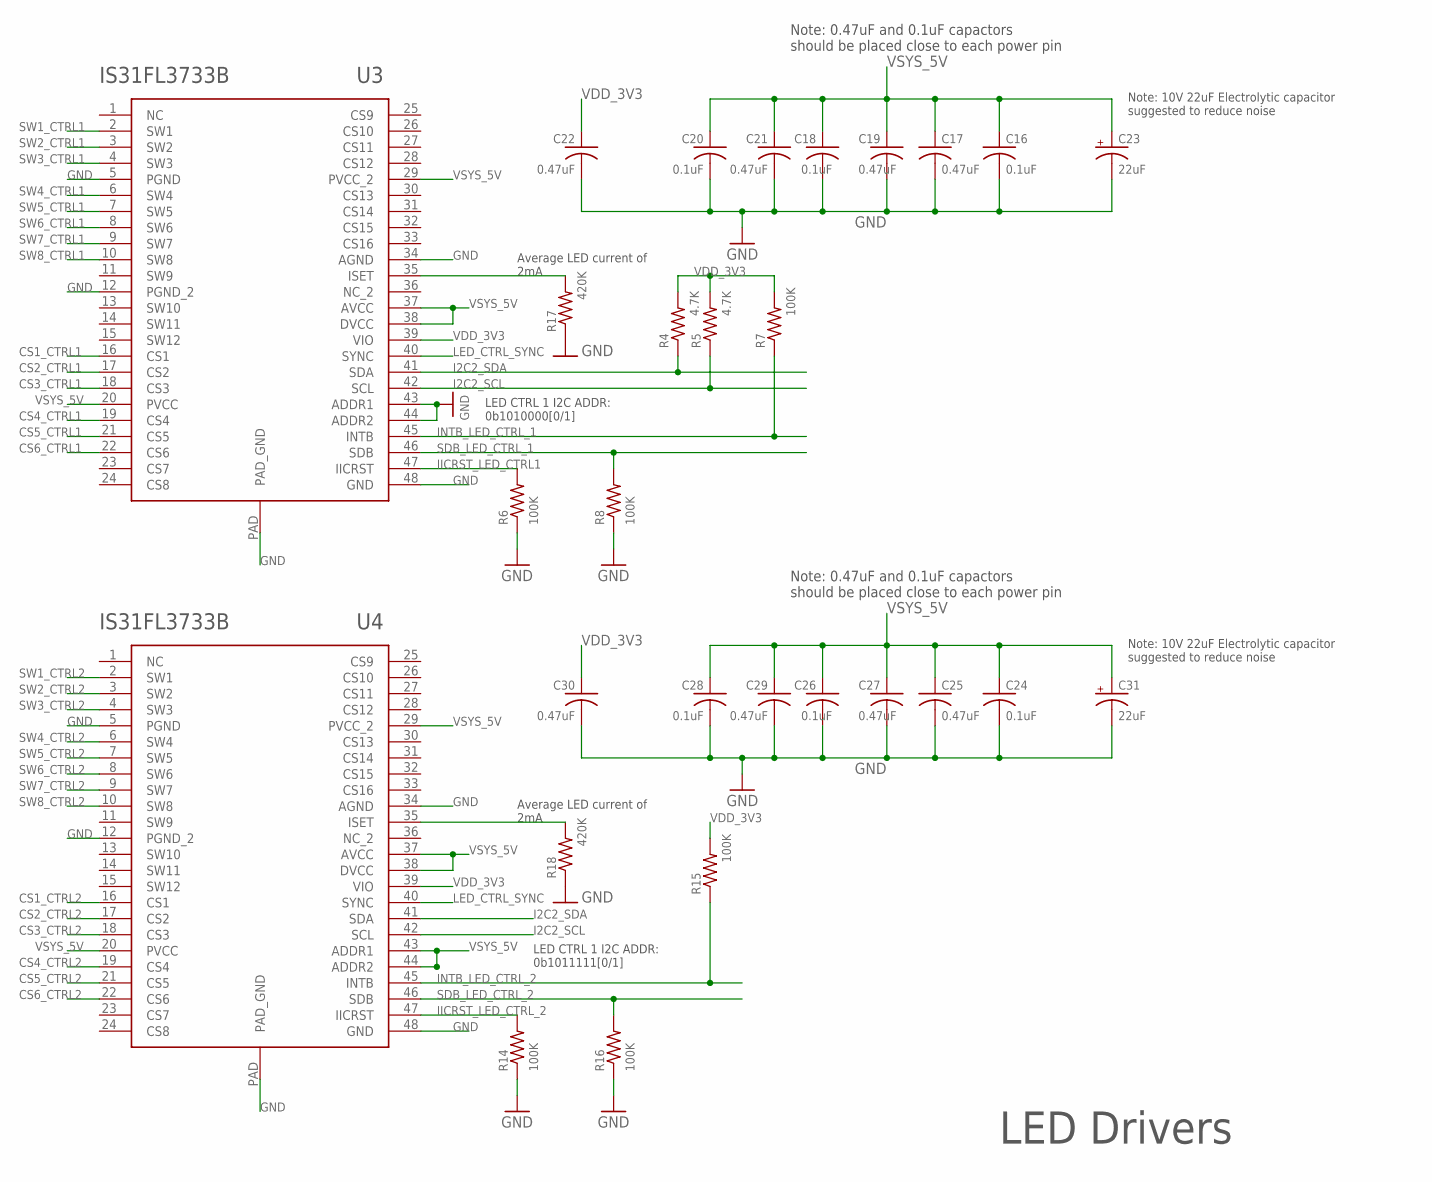
[picture p9: schematic FlexEval.sch, sheet 3]

Parts:
C16, C18, C20, C24, C26, C28: 0.1uF; C0805
C17, C19, C21, C22, C25, C27, C29, C30: 0.47uF; C0805
C23, C31: 22uF; 860020672011
R4, R5: 4.7K; R0805
R6, R7, R8, R14, R15, R16: 100K; R0805
R17, R18: 420K; R0805
U3, U4: IS31FL3733B-TQLS4

Connections:
CS1_CTRL1: U3.16 (CS1); also elsewhere on the board
CS1_CTRL2: U4.16 (CS1); also elsewhere on the board
CS2_CTRL1: U3.17 (CS2); also elsewhere on the board
CS2_CTRL2: U4.17 (CS2); also elsewhere on the board
CS3_CTRL1: U3.18 (CS3); also elsewhere on the board
CS3_CTRL2: U4.18 (CS3); also elsewhere on the board
CS4_CTRL1: U3.19 (CS4); also elsewhere on the board
CS4_CTRL2: U4.19 (CS4); also elsewhere on the board
CS5_CTRL1: U3.21 (CS5); also elsewhere on the board
CS5_CTRL2: U4.21 (CS5); also elsewhere on the board
CS6_CTRL1: U3.22 (CS6); also elsewhere on the board
CS6_CTRL2: U4.22 (CS6); also elsewhere on the board
GND: C16.2, C17.2, C18.2, C19.2, C20.2, C21.2, C22.2, C23.-, C24.2, C25.2, C26.2, C27.2, C28.2, C29.2, C30.2, C31.-, R6.1, R8.1, R14.1, R16.1, R17.1, R18.1, U3.5 (PGND), U3.12 (PGND_2), U3.34 (AGND), U3.43 (ADDR1), U3.44 (ADDR2), U3.48 (GND), U3.PAD (PAD_GND), U4.5 (PGND), U4.12 (PGND_2), U4.34 (AGND), U4.48 (GND), U4.PAD (PAD_GND); also elsewhere on the board
I2C2_SCL: R5.1, U3.42 (SCL), U4.42 (SCL); also elsewhere on the board
I2C2_SDA: R4.1, U3.41 (SDA), U4.41 (SDA); also elsewhere on the board
IICRST_LED_CTRL1: R6.2, U3.47 (IICRST)
IICRST_LED_CTRL_2: R14.2, U4.47 (IICRST)
INTB_LED_CTRL_1: R7.1, U3.45 (INTB); also elsewhere on the board
INTB_LED_CTRL_2: R15.1, U4.45 (INTB); also elsewhere on the board
LED_CTRL_SYNC: U3.40 (SYNC), U4.40 (SYNC)
unnamed: R17.2, U3.35 (ISET)
unnamed: R18.2, U4.35 (ISET)
SDB_LED_CTRL_1: R8.2, U3.46 (SDB); also elsewhere on the board
SDB_LED_CTRL_2: R16.2, U4.46 (SDB); also elsewhere on the board
SW1_CTRL1: U3.2 (SW1); also elsewhere on the board
SW1_CTRL2: U4.2 (SW1); also elsewhere on the board
SW2_CTRL1: U3.3 (SW2); also elsewhere on the board
SW2_CTRL2: U4.3 (SW2); also elsewhere on the board
SW3_CTRL1: U3.4 (SW3); also elsewhere on the board
SW3_CTRL2: U4.4 (SW3); also elsewhere on the board
SW4_CTRL1: U3.6 (SW4); also elsewhere on the board
SW4_CTRL2: U4.6 (SW4); also elsewhere on the board
SW5_CTRL1: U3.7 (SW5); also elsewhere on the board
SW5_CTRL2: U4.7 (SW5); also elsewhere on the board
SW6_CTRL1: U3.8 (SW6); also elsewhere on the board
SW6_CTRL2: U4.8 (SW6); also elsewhere on the board
SW7_CTRL1: U3.9 (SW7); also elsewhere on the board
SW7_CTRL2: U4.9 (SW7); also elsewhere on the board
SW8_CTRL1: U3.10 (SW8); also elsewhere on the board
SW8_CTRL2: U4.10 (SW8); also elsewhere on the board
VDD_3V3: C22.1, C30.1, R4.2, R5.2, R7.2, R15.2, U3.39 (VIO), U4.39 (VIO); also elsewhere on the board
VSYS_5V: C16.1, C17.1, C18.1, C19.1, C20.1, C21.1, C23.+, C24.1, C25.1, C26.1, C27.1, C28.1, C29.1, C31.+, U3.20 (PVCC), U3.29 (PVCC_2), U3.37 (AVCC), U3.38 (DVCC), U4.20 (PVCC), U4.29 (PVCC_2), U4.37 (AVCC), U4.38 (DVCC), U4.43 (ADDR1), U4.44 (ADDR2); also elsewhere on the board

Notes on the sheet:
LED Drivers
Note: 10V 22uF Electrolytic capacitor suggested to reduce noise
LED CTRL 1 I2C ADDR: 0b1010000[0/1]
Note: 0.47uF and 0.1uF capactors should be placed close to each power pin
LED CTRL 1 I2C ADDR: 0b1011111[0/1]
Average LED current of 2mA

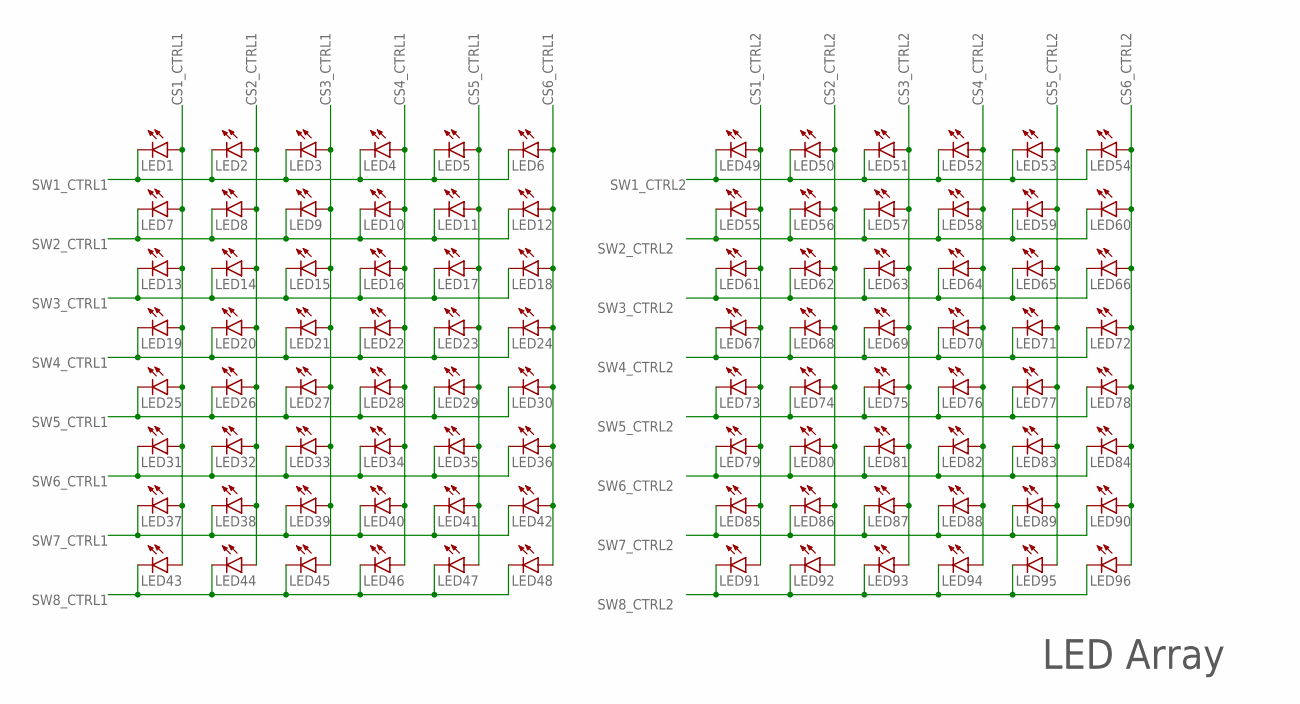
[picture p10: schematic FlexEval.sch, sheet 4]

Parts:
LED1, LED2, LED3, LED4, LED5, LED6, LED7, LED8, LED9, LED10, LED11, LED12, LED13, LED14, LED15, LED16, LED17, LED18, LED19, LED20, LED21, LED22, LED23, LED24, LED25, LED26, LED27, LED28, LED29, LED30, LED31, LED32, LED33, LED34, LED35, LED36, LED37, LED38, LED39, LED40, LED41, LED42, LED43, LED44, LED45, LED46, LED47, LED48, LED49, LED50, LED51, LED52, LED53, LED54, LED55, LED56, LED57, LED58, LED59, LED60, LED61, LED62, LED63, LED64, LED65, LED66, LED67, LED68, LED69, LED70, LED71, LED72, LED73, LED74, LED75, LED76, LED77, LED78, LED79, LED80, LED81, LED82, LED83, LED84, LED85, LED86, LED87, LED88, LED89, LED90, LED91, LED92, LED93, LED94, LED95, LED96: LED3MM

Connections:
CS1_CTRL1: LED1.A, LED7.A, LED13.A, LED19.A, LED25.A, LED31.A, LED37.A, LED43.A; also elsewhere on the board
CS1_CTRL2: LED49.A, LED55.A, LED61.A, LED67.A, LED73.A, LED79.A, LED85.A, LED91.A; also elsewhere on the board
CS2_CTRL1: LED2.A, LED8.A, LED14.A, LED20.A, LED26.A, LED32.A, LED38.A, LED44.A; also elsewhere on the board
CS2_CTRL2: LED50.A, LED56.A, LED62.A, LED68.A, LED74.A, LED80.A, LED86.A, LED92.A; also elsewhere on the board
CS3_CTRL1: LED3.A, LED9.A, LED15.A, LED21.A, LED27.A, LED33.A, LED39.A, LED45.A; also elsewhere on the board
CS3_CTRL2: LED51.A, LED57.A, LED63.A, LED69.A, LED75.A, LED81.A, LED87.A, LED93.A; also elsewhere on the board
CS4_CTRL1: LED4.A, LED10.A, LED16.A, LED22.A, LED28.A, LED34.A, LED40.A, LED46.A; also elsewhere on the board
CS4_CTRL2: LED52.A, LED58.A, LED64.A, LED70.A, LED76.A, LED82.A, LED88.A, LED94.A; also elsewhere on the board
CS5_CTRL1: LED5.A, LED11.A, LED17.A, LED23.A, LED29.A, LED35.A, LED41.A, LED47.A; also elsewhere on the board
CS5_CTRL2: LED53.A, LED59.A, LED65.A, LED71.A, LED77.A, LED83.A, LED89.A, LED95.A; also elsewhere on the board
CS6_CTRL1: LED6.A, LED12.A, LED18.A, LED24.A, LED30.A, LED36.A, LED42.A, LED48.A; also elsewhere on the board
CS6_CTRL2: LED54.A, LED60.A, LED66.A, LED72.A, LED78.A, LED84.A, LED90.A, LED96.A; also elsewhere on the board
SW1_CTRL1: LED1.K (C), LED2.K (C), LED3.K (C), LED4.K (C), LED5.K (C), LED6.K (C); also elsewhere on the board
SW1_CTRL2: LED49.K (C), LED50.K (C), LED51.K (C), LED52.K (C), LED53.K (C), LED54.K (C); also elsewhere on the board
SW2_CTRL1: LED7.K (C), LED8.K (C), LED9.K (C), LED10.K (C), LED11.K (C), LED12.K (C); also elsewhere on the board
SW2_CTRL2: LED55.K (C), LED56.K (C), LED57.K (C), LED58.K (C), LED59.K (C), LED60.K (C); also elsewhere on the board
SW3_CTRL1: LED13.K (C), LED14.K (C), LED15.K (C), LED16.K (C), LED17.K (C), LED18.K (C); also elsewhere on the board
SW3_CTRL2: LED61.K (C), LED62.K (C), LED63.K (C), LED64.K (C), LED65.K (C), LED66.K (C); also elsewhere on the board
SW4_CTRL1: LED19.K (C), LED20.K (C), LED21.K (C), LED22.K (C), LED23.K (C), LED24.K (C); also elsewhere on the board
SW4_CTRL2: LED67.K (C), LED68.K (C), LED69.K (C), LED70.K (C), LED71.K (C), LED72.K (C); also elsewhere on the board
SW5_CTRL1: LED25.K (C), LED26.K (C), LED27.K (C), LED28.K (C), LED29.K (C), LED30.K (C); also elsewhere on the board
SW5_CTRL2: LED73.K (C), LED74.K (C), LED75.K (C), LED76.K (C), LED77.K (C), LED78.K (C); also elsewhere on the board
SW6_CTRL1: LED31.K (C), LED32.K (C), LED33.K (C), LED34.K (C), LED35.K (C), LED36.K (C); also elsewhere on the board
SW6_CTRL2: LED79.K (C), LED80.K (C), LED81.K (C), LED82.K (C), LED83.K (C), LED84.K (C); also elsewhere on the board
SW7_CTRL1: LED37.K (C), LED38.K (C), LED39.K (C), LED40.K (C), LED41.K (C), LED42.K (C); also elsewhere on the board
SW7_CTRL2: LED85.K (C), LED86.K (C), LED87.K (C), LED88.K (C), LED89.K (C), LED90.K (C); also elsewhere on the board
SW8_CTRL1: LED43.K (C), LED44.K (C), LED45.K (C), LED46.K (C), LED47.K (C), LED48.K (C); also elsewhere on the board
SW8_CTRL2: LED91.K (C), LED92.K (C), LED93.K (C), LED94.K (C), LED95.K (C), LED96.K (C); also elsewhere on the board

Notes on the sheet:
LED Array

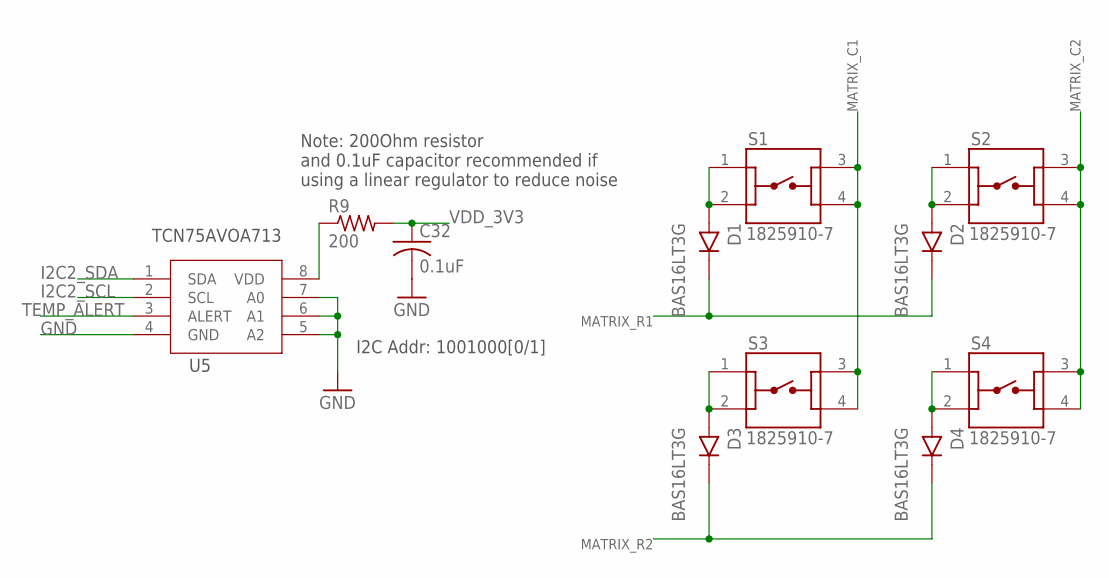
[picture p11: schematic FlexEval.sch, sheet 5]

Parts:
C32: 0.1uF; C0805
D1, D2, D3, D4: BAS16LT3G; SOT95P240X111-3N
R9: 200; R0805
S1, S2, S3, S4: 1825910-7; SW_1825910-7
U5: SOIC127P600X175-8N

Connections:
GND: C32.2, U5.4 (GND), U5.5 (A2), U5.6 (A1), U5.7 (A0); also elsewhere on the board
I2C2_SCL: U5.2 (SCL); also elsewhere on the board
I2C2_SDA: U5.1 (SDA); also elsewhere on the board
MATRIX_C1: S1.3, S1.4, S3.3, S3.4; also elsewhere on the board
MATRIX_C2: S2.3, S2.4, S4.3, S4.4; also elsewhere on the board
MATRIX_R1: D1.3 (C), D2.3 (C); also elsewhere on the board
MATRIX_R2: D3.3 (C), D4.3 (C); also elsewhere on the board
unnamed: D1.1 (A), S1.1, S1.2
unnamed: D2.1 (A), S2.1, S2.2
unnamed: D3.1 (A), S3.1, S3.2
unnamed: D4.1 (A), S4.1, S4.2
unnamed: R9.1, U5.8 (VDD)
TEMP_ALERT: U5.3 (ALERT); also elsewhere on the board
VDD_3V3: C32.1, R9.2; also elsewhere on the board

Notes on the sheet:
I2C Addr: 1001000[0/1]
Note: 200Ohm resistor and 0.1uF capacitor recommended if using a linear regulator to reduce noise

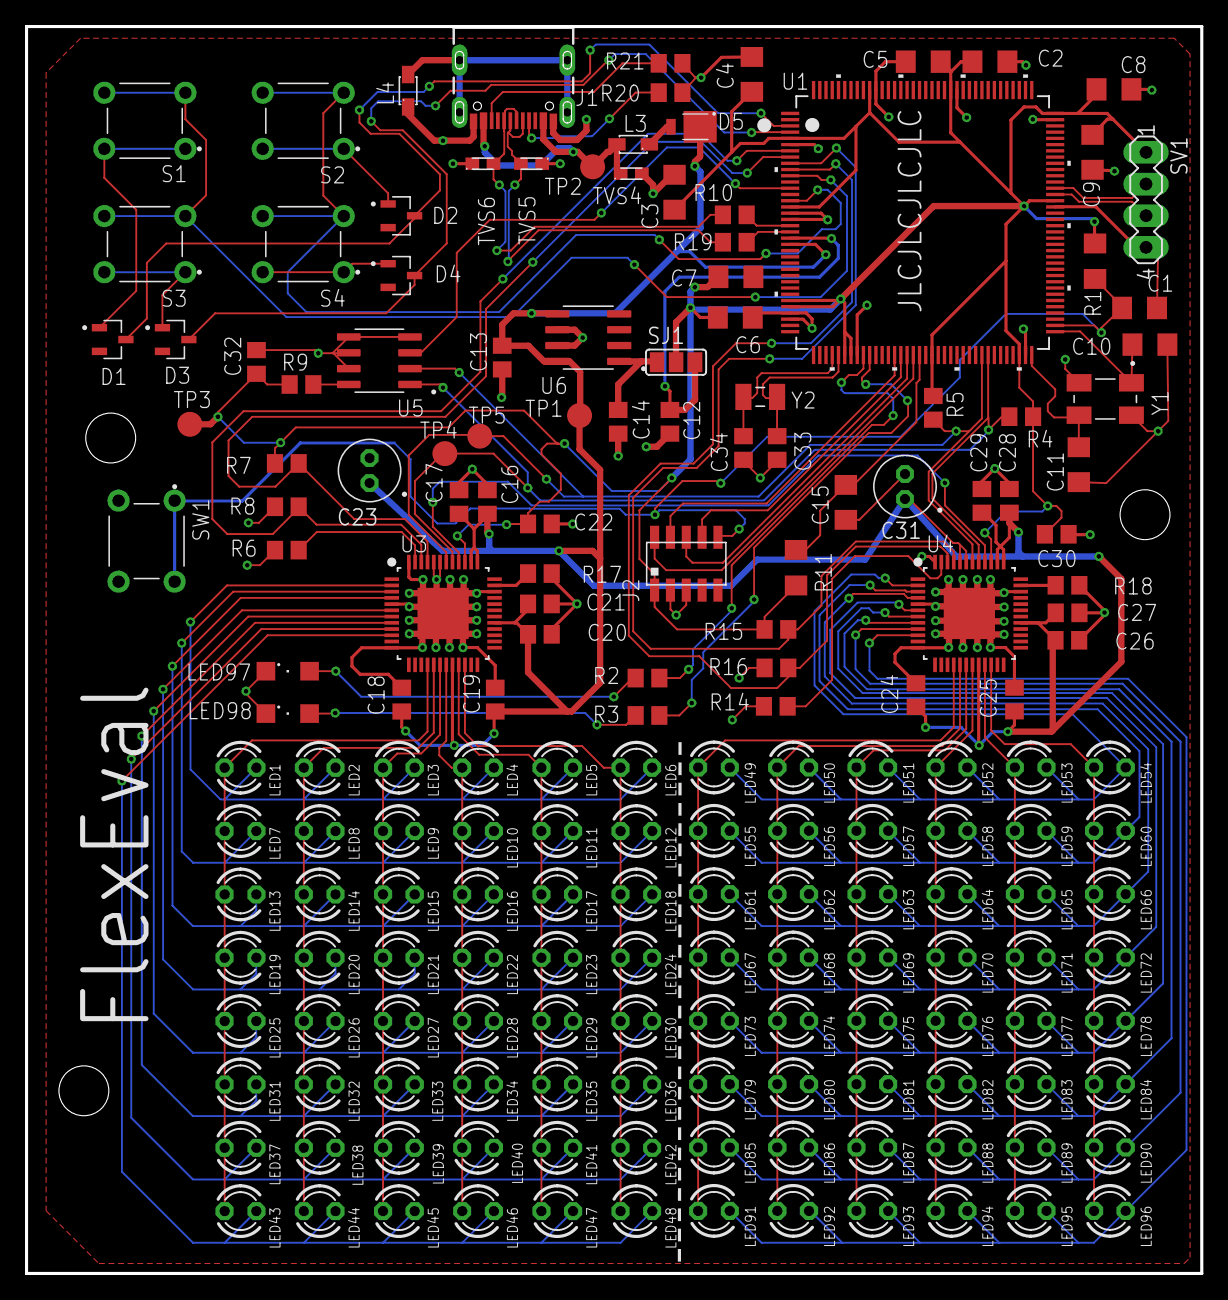
[picture p12: board FlexEval.brd from above]

Board: 2 copper layers, 94.2 x 100.0 mm, 182 parts (0 on the bottom side), 79 nets.
