danieldegrasse/FlexEval/(commit log)

2022-10-15 Initial commit: added all required library files and board design
    Board design passes JLCPCB DRC, and Eagle default ERC. Board is
    fully routed, but final manufacturing checks are not complete, and
    no BOM is generated.
    [FlexEval.brd, FlexEval.sch]
2022-10-16 schematic: update resistors and capacitors to Eagle libraries
    Updated all resistors and capacitors to use Eagle libraries instead
    of custom SnapEDA variants for each component. This should improve
    flexibility of the design, since SMD packages for passives are standard
    sizes.
    [FlexEval.brd, FlexEval.sch]
2022-10-16 board: replaced Electrolytic Capactitors
    Replaced electrolytic capacitors with real models, instead of
    Eagle's default library
    [FlexEval.brd, FlexEval.sch]
2022-10-16 BOM: added initial BOM. This should hopefully remain final.
    Board is passing DRC, and all components that need to be ordered
    are currently in stock.
    [BOM.xlsx]
2022-10-16 board: added test points and debug LEDs
    Added two debug LEDs, and test points on I2C and voltage signals. BOM
    updated with 2 additional 200 Ohm resistors and 2 1206 LEDs
    [BOM.xlsx, FlexEval.brd, FlexEval.sch]
2022-10-16 libraries : updated USB4105-GF-A connector footprint, removed USB4105 lib
    Removed USB4105 lib, as that library is not in use.
    Updated USB4105-GF-A footprint with the following patches:
    - extended all pads to 1.35mm (beyond manufacturer recommendation of 1.15)
    to make hand soldering easier
    - moved GND connectors up by 0.1mm to fix clearance issue with drilled
    holes
    - increased milled holes to 0.66mm from 0.6mm diameter to accommodate
    JLPCB manufacturing tolerances
    [FlexEval.brd, FlexEval.sch]
2022-10-16 board: cleaned up text locations and switched to vector fonts
    Cleaned up board text locations (and added some decoration).
    Switched all fonts on tNames layer to vector fonts.
    Added "JLCJLCJLCJLC" to silkscreen, for JLCPCB order number
    location
    [FlexEval.brd]
2022-10-16 Manufacturing: generated gerber files
    Generated gerber files for JLCPCB. Board should be ready for order.
2022-10-16 BOM: added extra quantities to items for order
    Added extra quantities to order list, in case a part is lost
    or damaged during assembly.
    [BOM.xlsx]
2023-06-17 board: created layout and schematic PDFS
    Created layout and schematic PDFs, to make search board components
    easier.
